swedishhat/remote-io/doc/board-files/r01_schem.pdf

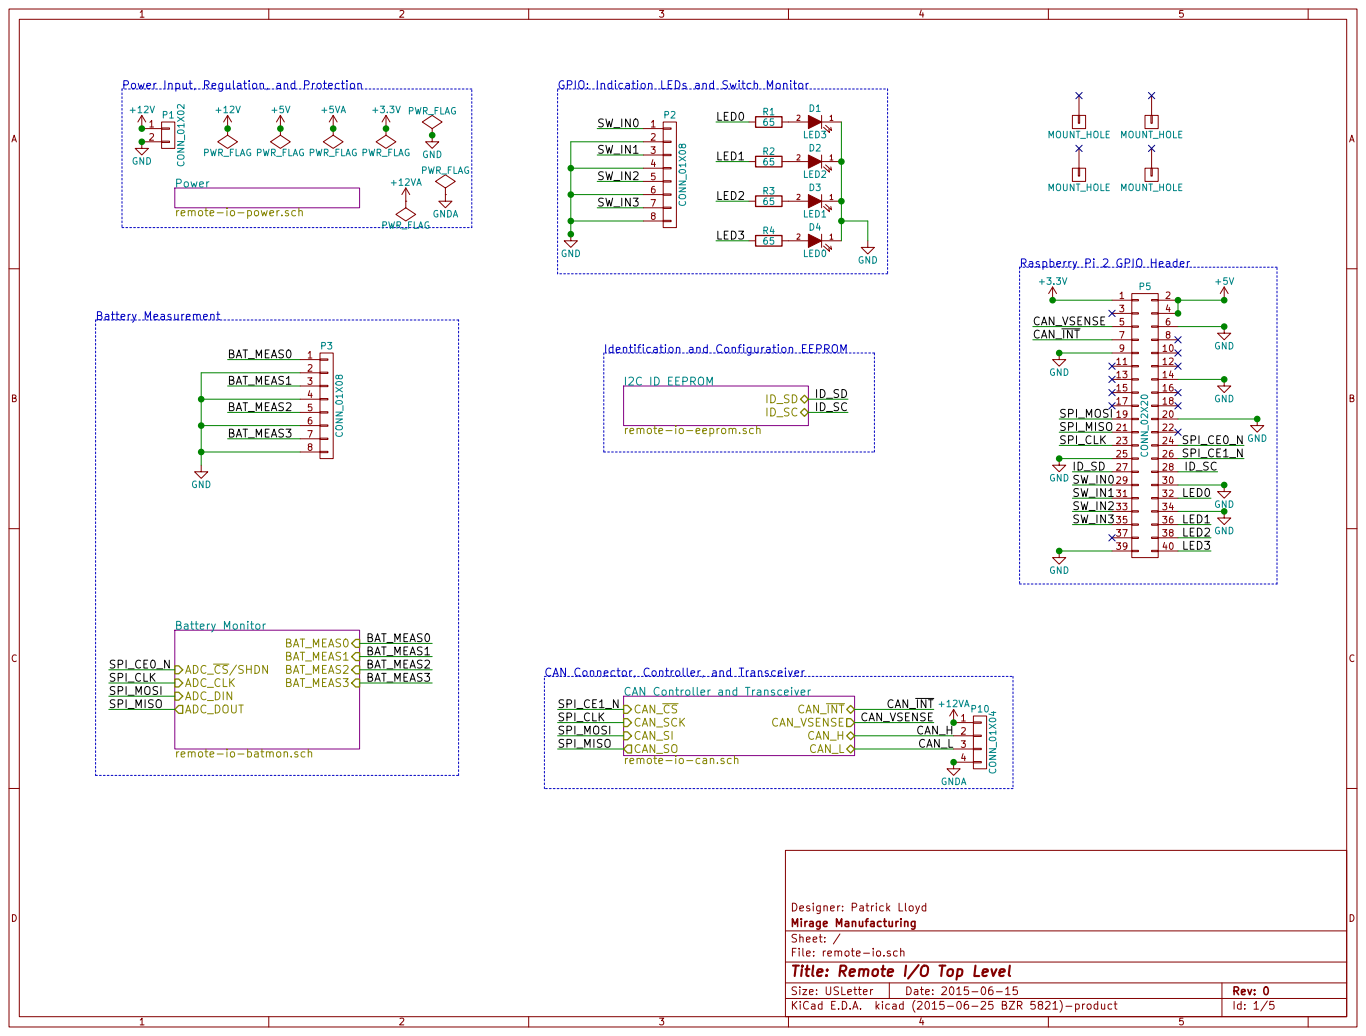
[picture p1: page 1]

Power Input, Regulation, and Protection

GPIO: Indication LEDs and Switch Monitor

Identification and Configuration EEPROM

remote-io-eeprom.sch

CAN Connector, Controller, and Transceiver

Designer: Patrick Lloyd
Id: 1/5 Title: Remote I/O Top Level File: remote-io.sch Sheet: / Mirage Manufacturing

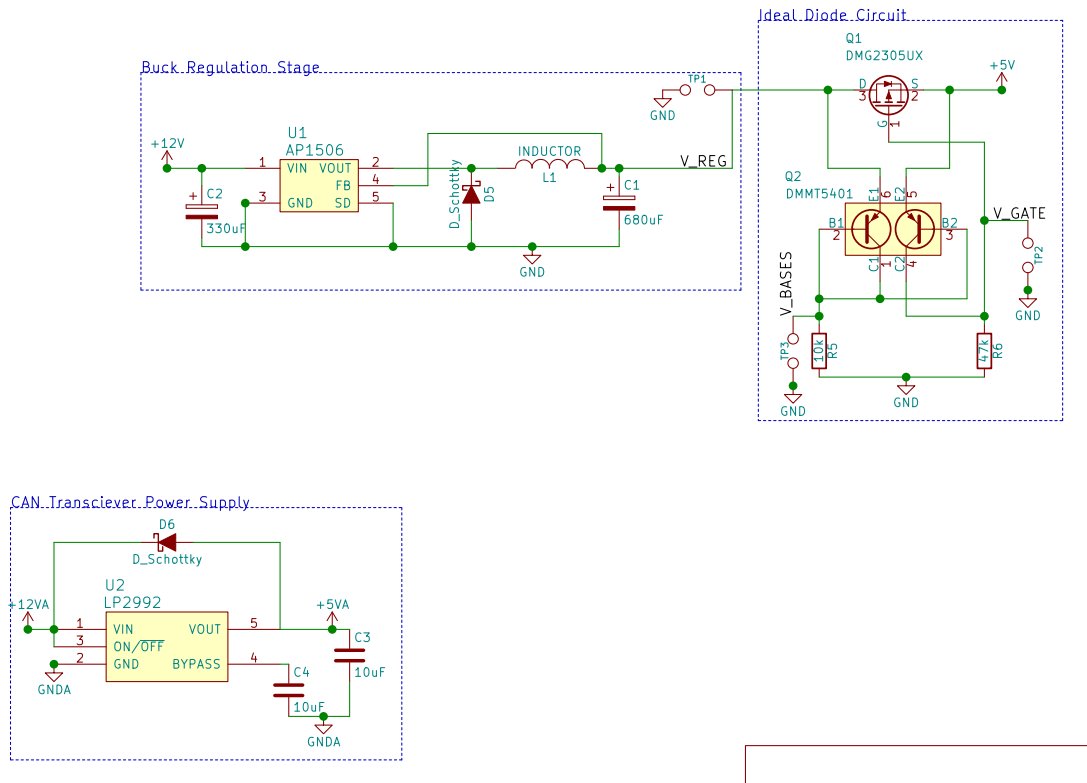
[picture p2: page 2]

Designer: Patrick Lloyd
File: remote-io-power.sch Sheet: /Power/ Mirage Manufacturing

Id: 2/5 Title: Remote I/O Power Section

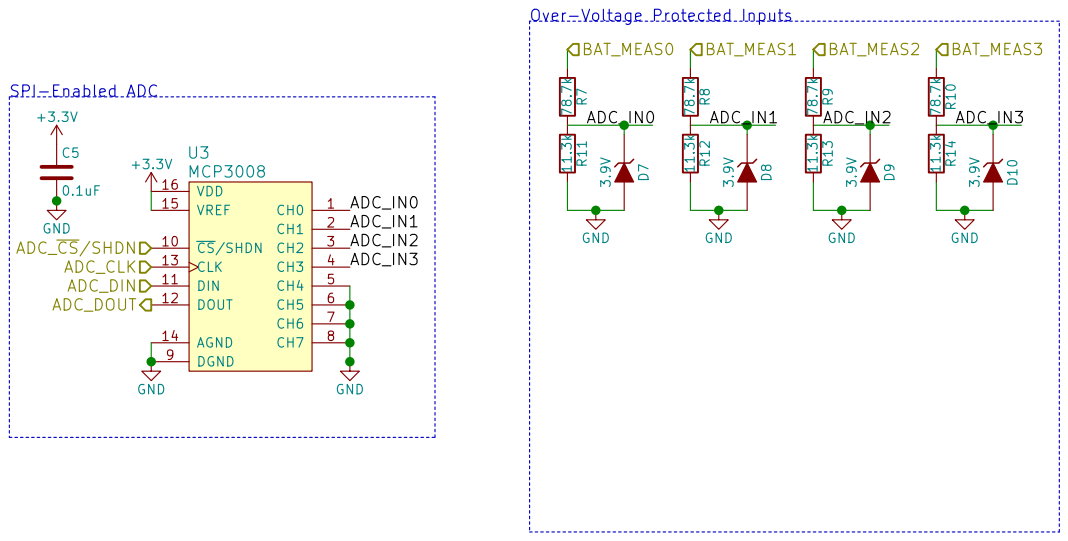
[picture p3: page 3]

Over-Voltage Protected Inputs C5

Designer: Patrick Lloyd
Mirage Manufacturing
Id: 3/5 Title: Battery Monitor File: remote-io-batmon.sch Sheet: /Battery Monitor/

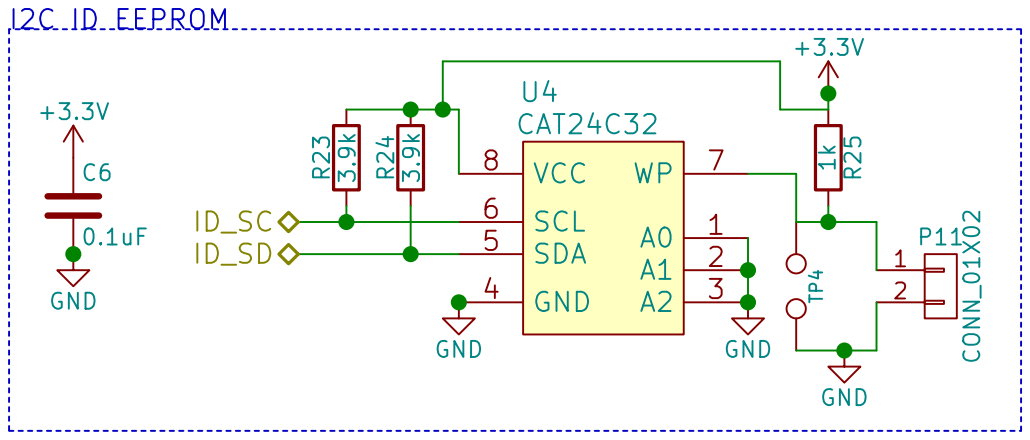
[picture p4: page 4]

Designer: Patrick Lloyd
File: remote-io-eeprom.sch Sheet: /I2C ID EEPROM/ Mirage Manufacturing

Id: 4/5 Title: I2C ID EEPROM

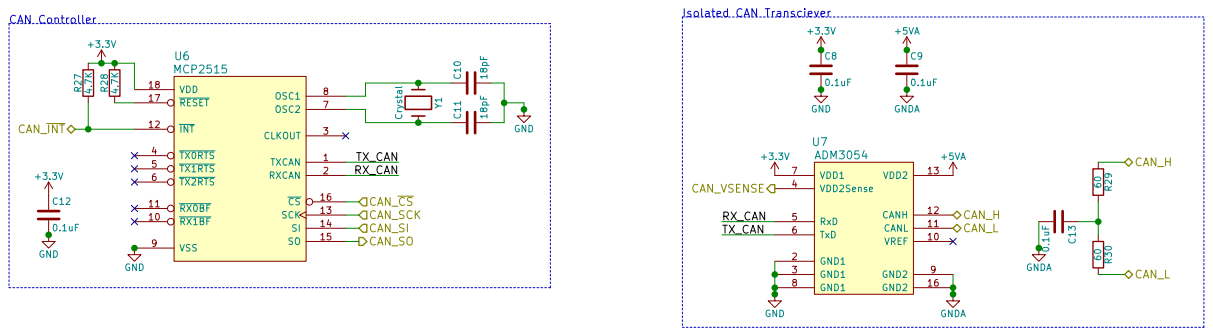
[picture p5: page 5]
