swedishhat/remote-io/doc/board-files/r01_pcb.pdf

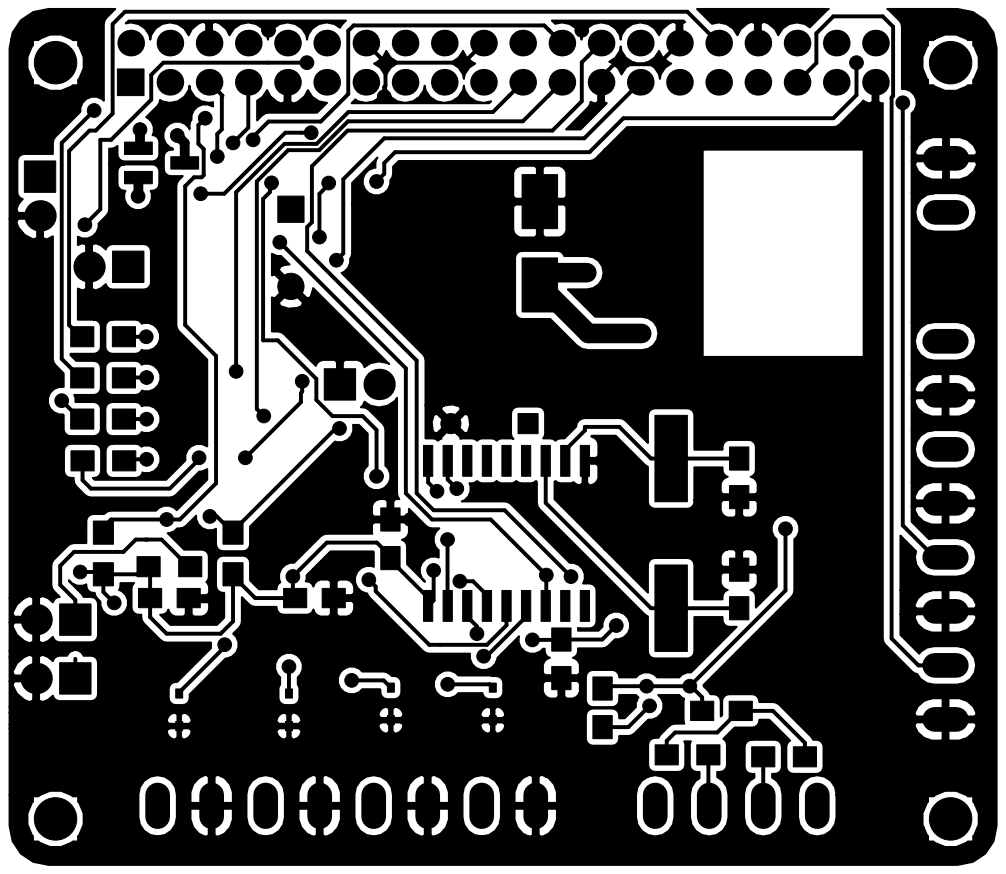
[picture p6: page 1]

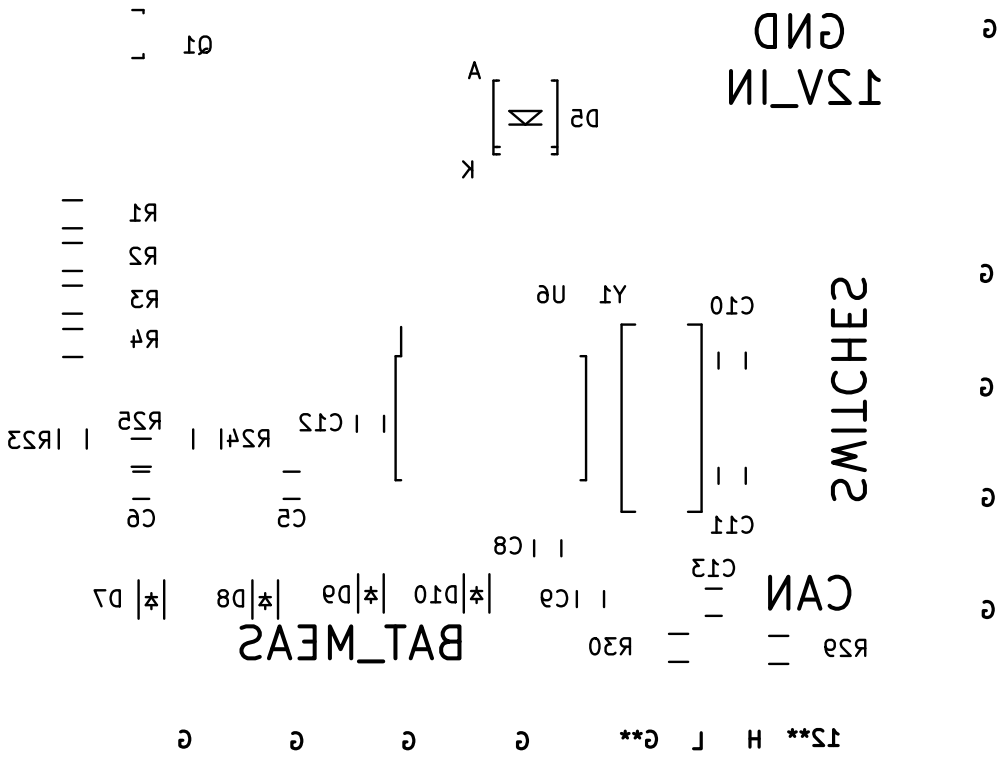
[picture p7: page 3]

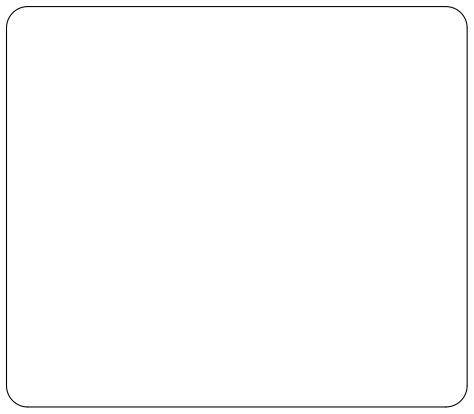
[picture p8: figure]
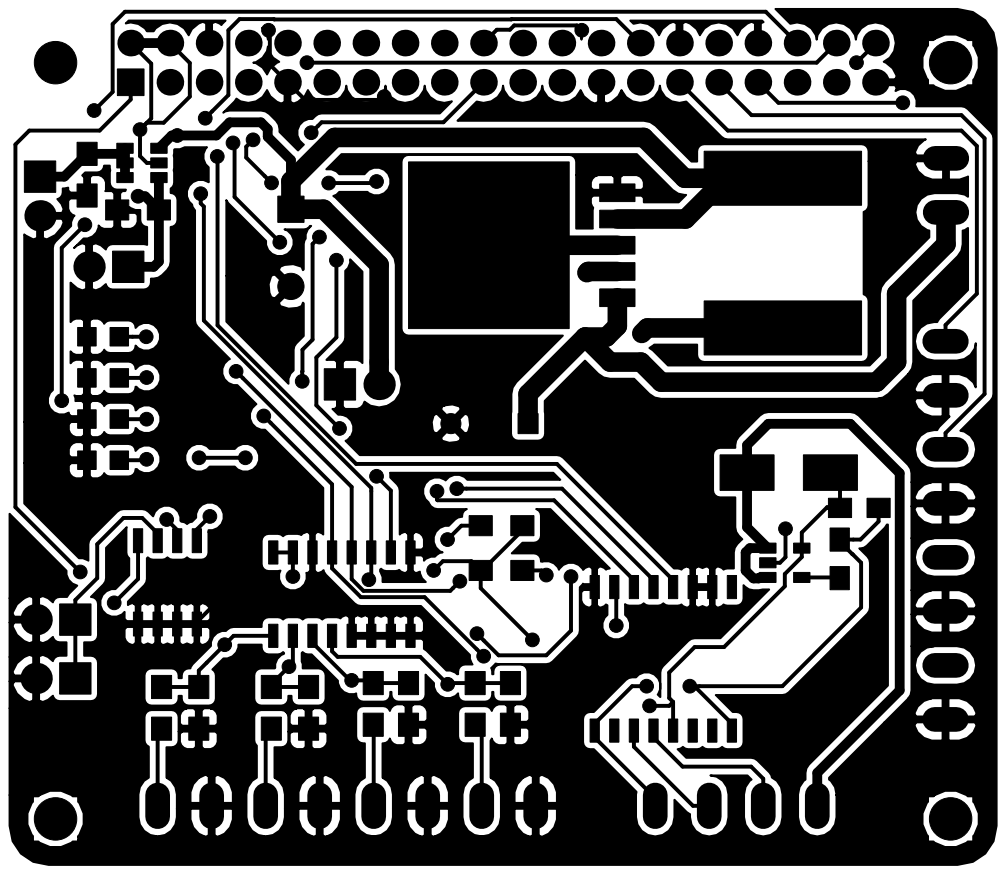
[picture p9: page 5]

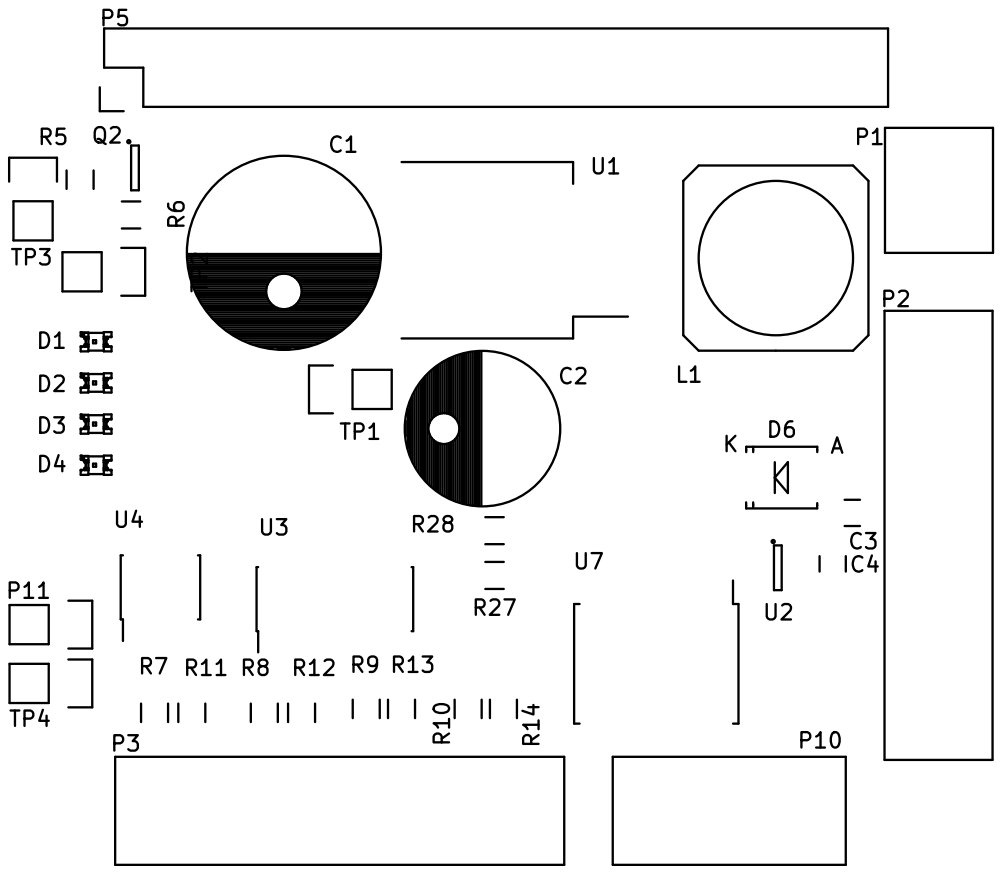
[picture p10: page 7]
