swedishhat/remote-io/(list of files, drawings)

Other design files:
hw/altium/CAT24C32 Breakout/CAT24C32 Breakout.PrjPcb
hw/altium/CAT24C32 Breakout/CAT24C32 Breakout.SchDoc
hw/altium/remote-io_r2/remote-io_r2.PrjPcb
hw/altium/RemoteIO R02/Battery Monitor.SchDoc
hw/altium/RemoteIO R02/CAN Interface.SchDoc
hw/altium/RemoteIO R02/RemoteIO R02.PrjPcb
hw/altium/RemoteIO R02/Top Level.SchDoc
hw/rev0_legacy/altium/CAT24C32 Breakout/CAT24C32 Breakout.PcbDoc
hw/rev0_legacy/altium/CAT24C32 Breakout/CAT24C32 Breakout.PrjPcb
hw/rev0_legacy/altium/CAT24C32 Breakout/CAT24C32 Breakout.SchDoc
hw/rev0_legacy/altium/RemoteIO R02/Battery Monitor.SchDoc
hw/rev0_legacy/altium/RemoteIO R02/CAN Interface.SchDoc
hw/rev0_legacy/altium/RemoteIO R02/RemoteIO R02.PrjPcb
hw/rev0_legacy/altium/RemoteIO R02/Top Level.SchDoc
hw/rev0_legacy/altium/RIO CAN Breakout/RIO CAN Breakout.PcbDoc
hw/rev0_legacy/altium/RIO CAN Breakout/RIO CAN Breakout.PrjPcb
hw/rev0_legacy/altium/RIO CAN Breakout/RIO CAN Breakout.SchDoc
