swedishhat/remote-io/(commit log)

2015-06-16 Added ADC schematic and connections
    [remote-io-batmon.sch, remote-io-power.sch, remote-io.sch]
2015-06-16 Added I2C ID EEPROM
    [remote-io-batmon.sch, remote-io-eeprom.sch, remote-io-power.sch, remote-io.sch]
2015-06-16 Added RS-422 sheet to top level
    [remote-io-rs422.sch, remote-io.sch]
2015-06-16 Added RS-422 Receiver Circuit
    [remote-io-batmon.sch, remote-io-eeprom.sch, remote-io-power.sch, remote-io-rs422.sch, remote-io.sch]
2015-06-16 RS-422 Tweaks
    [remote-io.sch]
2015-06-16 Finished first revision of schematic
    [remote-io.sch]
2015-06-16 Updated .gitignore with recs from en.wikibooks.org/wiki/Kicad/file_formats
2015-06-17 Matched all footprints to schem and created kicad_pcb file
    [hat-design.kicad_pcb, remote-io-batmon.sch, remote-io-eeprom.sch, remote-io-power.sch, remote-io-rs422.sch, remote-io.kicad_pcb, remote-io.sch]
2015-06-17 added .pcb-back to gitignore and resynced
2015-06-17 Whoops. Added .kicad_pcb-back to gitignore and resynced
    [_saved_remote-io-power.sch]
2015-06-17 removed autosave
    [_saved_remote-io-power.sch, remote-io-eeprom.sch, remote-io-power.sch]
2015-06-17 added CAN power, controller, and transceiver to schem and updated PCB
    [remote-io-batmon.sch, remote-io-can.sch, remote-io-eeprom.sch, remote-io-power.sch, remote-io-rs422.sch, remote-io.kicad_pcb, remote-io.sch]
2015-06-17 Hoping to get rid of nested git repos
    [CANpi.kicad_pcb, CANpi.sch, adc_pi-dock.SchDoc, hat-design.kicad_pcb, hat-design.sch, namur_pi-dock.SchDoc, pi-dock.PcbDoc, pi-dock.PrjPcb]
2015-06-17 removed fucking goddamn submodules
    [CANpi.kicad_pcb, CANpi.sch, hat-design.kicad_pcb, hat-design.sch]
2015-06-19 Started fucking aroond with pcb layout. Power is tricky...
    [remote-io-batmon.sch, remote-io-can.sch, remote-io-eeprom.sch, remote-io-power.sch, remote-io-rs422.sch, remote-io.kicad_pcb, remote-io.sch]
2015-06-22 All parts in hat-spec-size board
    [remote-io-batmon.sch, remote-io-can.sch, remote-io-eeprom.sch, remote-io-power.sch, remote-io.kicad_pcb, remote-io.sch]
2015-06-23 Edited board dims to get rid of flex cutout. May need to move conns to other side
    [remote-io-batmon.sch, remote-io-can.sch, remote-io-eeprom.sch, remote-io-power.sch, remote-io-wrong-side.kicad_pcb, remote-io.sch]
2015-06-23 Preliminary routing of board. Messy but whatever... it's a rev 0
    [remote-io-hand-route.kicad_pcb, remote-io.kicad_pcb]
2015-06-23 removed extraneous sheets and pro files
    [remote-io-hand-route.kicad_pcb, remote-io-wrong-side.kicad_pcb]
2015-06-25 Isolated CAN bus connections and added proper mounting holes
    [remote-io-batmon.sch, remote-io-can.sch, remote-io-eeprom.sch, remote-io-power.sch, remote-io.kicad_pcb, remote-io.sch]
2015-06-25 Finished rev 0 with gerbers and drills
    [remote-io-B_Cu.gbl, remote-io-B_Mask.gbs, remote-io-B_SilkS.gbo, remote-io-Edge_Cuts.gm1, remote-io-F_Cu.gtl, remote-io-F_Mask.gts, remote-io-F_SilkS.gto, remote-io.drl]
2015-06-25 added invoices for BoM and tools
    [remote-io_invoice.ods]
2015-06-29 Added PCB and schematic prints
    [remote-io.kicad_pcb, remote-io.sch]
2016-01-18 Why did I have invoices in there?
    [remote-io.kicad_pcb]
2016-01-18 Updated readme and worked on SPI (outside git)
    [remote-io_invoice.ods]
2017-03-27 Redoing it in Altium because of why not
    [Battery Monitor.SchDoc, CAN Interface.SchDoc, Top Level.SchDoc, adc_pi-dock.SchDoc, hat-design.kicad_pcb, namur_pi-dock.SchDoc, pi-dock.PcbDoc, pi-dock.PrjPcb]
2017-03-27 Made breakout for EEPROM to test with othermill
    [Battery Monitor.SchDoc, CAN Interface.SchDoc, CAT24C32 Breakout.PcbDoc, CAT24C32 Breakout.PrjPcb, CAT24C32 Breakout.SchDoc, RemoteIO R02.PrjPcb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]
2017-05-14 Restructure. Revving to 1, all older files considered r0_legacy
    [Battery Monitor.SchDoc, CAN Interface.SchDoc, CAT24C32 Breakout.PcbDoc, CAT24C32 Breakout.PrjPcb, CAT24C32 Breakout.SchDoc, RIO CAN Breakout.PcbDoc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]
2017-05-15 Did project research. Using TI ISO1050 for can isolation and ref design in datsheet
    [_saved_remote-io-can.sch, _saved_remote-io.sch, hat-design.kicad_pcb, remote-io.kicad_pcb, remote-io.sch, remote-io_rev1.kicad_pcb, remote-io_rev1.sch]
